zhujunsan/p3-clicker/hardware/model/P3_Clicker.step

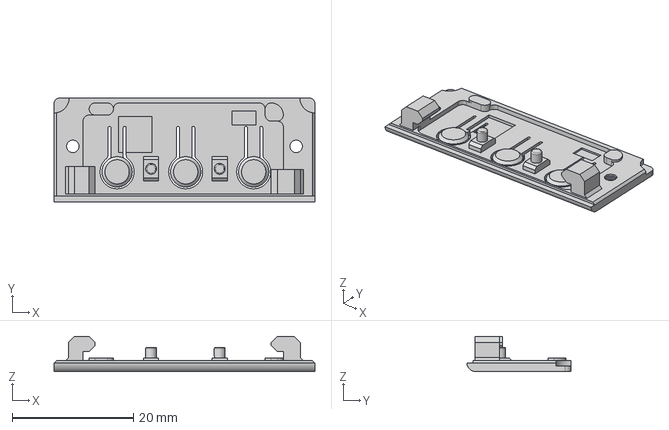
[picture p7: CAD file, 2022-03-19]
hardware/model/P3_Clicker.step
43.0 x 17.2 x 5.80 mm
