zhujunsan/p3-clicker/(list of files, cad)

Other CAD files:
hardware/model/P3_Clicker.f3d
hardware/model/P3_Clicker.stl
