zhujunsan/p3-clicker/hardware/pcb/Schema.pdf

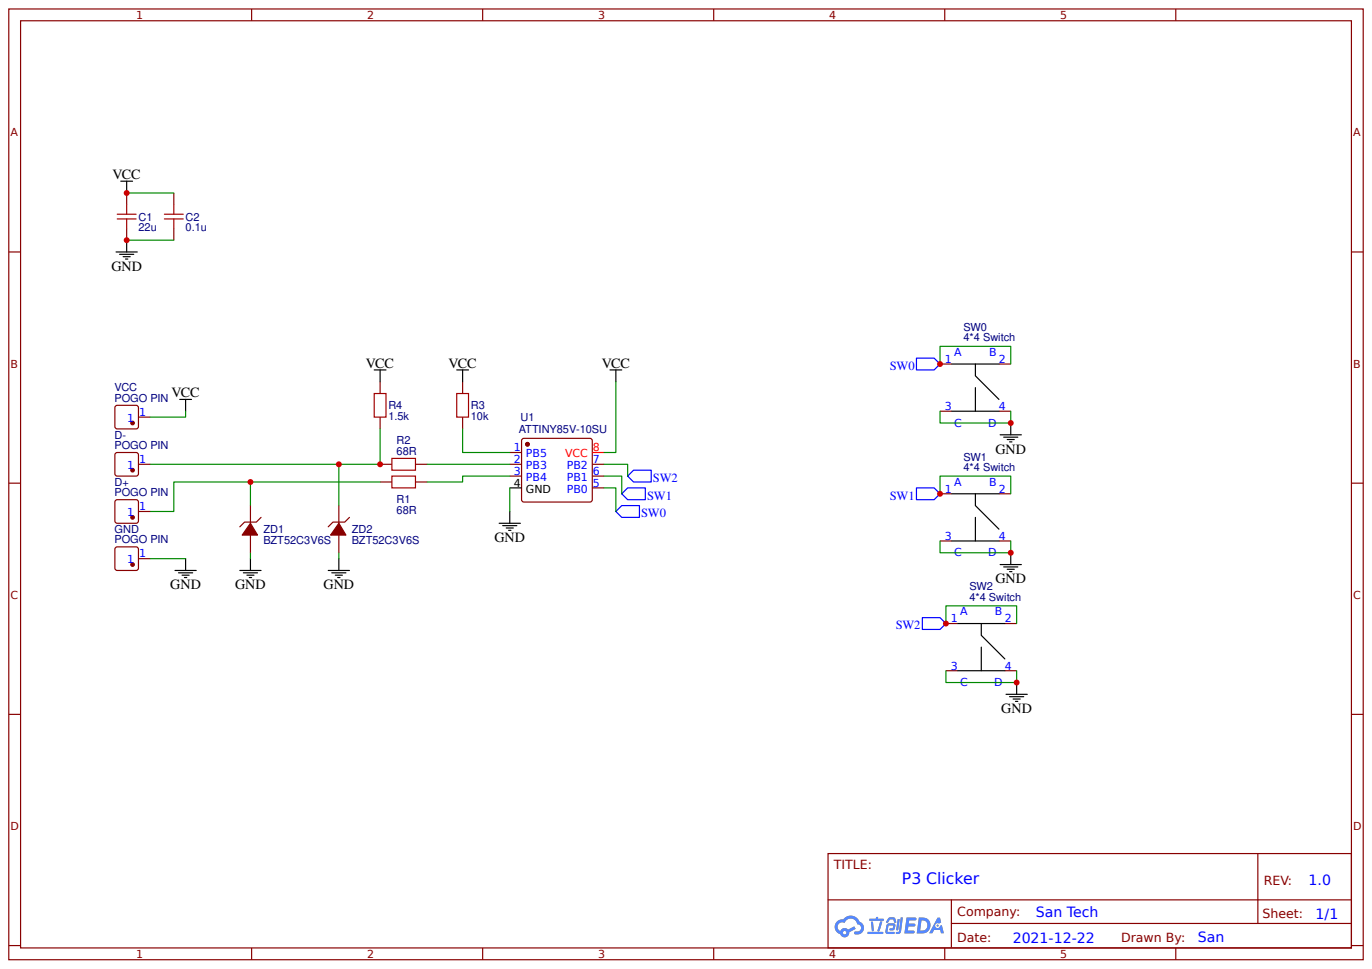
[picture p8: page 1]
